Ankit02124/AquaSense/docs/images/components/CREDITS.md

# Image credits

Photos of off-the-shelf parts used in the README. All are under free licenses and were only resized.

| file | what | author | license | source |
|---|---|---|---|---|
| arduino_uno_q.png | Arduino UNO Q | Arduino | CC BY-SA 4.0 | [arduino/docs-content](https://github.com/arduino/docs-content/tree/main/content/hardware/uno/boards/uno-q/datasheet/assets) |
| uno_q_block_diagram.png | UNO Q block diagram (QRB2210 + STM32U585) | Arduino | CC BY-SA 4.0 | [arduino/docs-content](https://github.com/arduino/docs-content/tree/main/content/hardware/uno/boards/uno-q/datasheet/assets) |
| uno_q_pinout.png | UNO Q pinout | Arduino | CC BY-SA 4.0 | [arduino/docs-content](https://github.com/arduino/docs-content/tree/main/content/hardware/uno/boards/uno-q/datasheet/assets) |
| pond_aerator.jpg | Aerators in an aquaculture pond, Eluru (Andhra Pradesh) | iMahesh | CC BY-SA 4.0 | [Wikimedia Commons](https://commons.wikimedia.org/wiki/File:Aeration_system_in_a_Aqua_Pond,_Eluru.jpg) |
| ds18b20_probe.jpg | Waterproof DS18B20 probe | Leonardo Postay | CC BY-SA 4.0 | [Wikimedia Commons](https://commons.wikimedia.org/wiki/File:Sensor_DS18B20.jpg) |
| ph_electrode.jpg | Glass pH electrode | Chandrajit Karmakar | CC BY-SA 4.0 | [Wikimedia Commons](https://commons.wikimedia.org/wiki/File:Glass_electrode.jpg) |
| usb_webcam.jpg | USB webcam | WrS.tm.pl | CC0 | [Wikimedia Commons](https://commons.wikimedia.org/wiki/File:USB_webcam_for_PC.jpg) |
