Ankit02124/AquaSense/training/results/results.csv

epoch | time | train/box_loss | train/cls_loss | train/dfl_loss | metrics/precision(B) | metrics/recall(B) | metrics/mAP50(B) | metrics/mAP50-95(B) | val/box_loss | val/cls_loss | val/dfl_loss | lr/pg0 | lr/pg1 | lr/pg2
1 | 95.6696 | 1.91926 | 2.97007 | 1.28118 | 0.61665 | 0.44876 | 0.50786 | 0.28556 | 1.63518 | 1.78096 | 1.20926 | 0.00036933 | 0.00036933 | 0.00036933
2 | 161.121 | 1.71932 | 1.51549 | 1.17335 | 0.61072 | 0.54336 | 0.56353 | 0.30446 | 1.68945 | 1.80136 | 1.23338 | 0.000727459 | 0.000727459 | 0.000727459
3 | 228.603 | 1.66067 | 1.33646 | 1.14503 | 0.69011 | 0.63642 | 0.71373 | 0.41975 | 1.45755 | 1.23804 | 1.13942 | 0.00107337 | 0.00107337 | 0.00107337
4 | 296.022 | 1.58337 | 1.20881 | 1.10977 | 0.75004 | 0.66224 | 0.72667 | 0.42984 | 1.42364 | 1.12387 | 1.11456 | 0.00105601 | 0.00105601 | 0.00105601
5 | 362.528 | 1.52234 | 1.11287 | 1.089 | 0.82535 | 0.69847 | 0.79696 | 0.47769 | 1.3737 | 1.0721 | 1.09453 | 0.00103767 | 0.00103767 | 0.00103767
6 | 427.479 | 1.48979 | 1.05851 | 1.06753 | 0.83756 | 0.67762 | 0.81452 | 0.50773 | 1.30999 | 0.96612 | 1.07524 | 0.00101934 | 0.00101934 | 0.00101934
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
