Ankit02124/AquaSense/(commit log)

2026-11-05 Add STM32 sketch: probe power switching, ADC readings, DS2484 temperature
    Probes are powered one at a time, read with 64 samples and switched off
    again. Linux starts a measurement over the Bridge and polls for the raw
    millivolt result.
2026-11-05 Add wiring diagram, schematics and hardware notes
2026-11-05 Support three-point pH calibration (pH 4/7/10)
    Least-squares fit when more than two buffers are given. Also note in the
    hardware README that the DS18B20 steel sheath must be insulated, otherwise it
    grounds the circuit through the water and disturbs the pH reading.
2026-11-05 Scale overlays with frame size, add --start to run_on_video, use fish frames for samples
2026-11-06 Add trained YOLOv8n model and training notes
    Fine-tuned on the Brackish Dataset (Kaggle), 60 epochs at 640 px.
    Exported to ONNX at 416 px for the UNO Q. Includes training curves,
    confusion matrix, PR curve and sample predictions.
    [results.csv]
2026-11-06 Shorter track trails in overlays, tidy schematic titles
2026-11-06 Keep running when the MCU does not answer, and other app fixes
    - probes.py returns safe values on Bridge errors; the controller aborts,
    switches the probes off and retries after the follow-up interval
    - aerator switches off only once DO is a margin above the warning level
    - scheduled checks use the timezone from config.yaml
    - config.local.yaml is merged at any depth (settings.py)
    - windows too dark to see the fish raise no alerts
    - longest still time is the maximum over the whole window
    - main.py pings the MCU once a minute and saves at most one snapshot a minute
    - run_on_video.py can save clean frames for labelling (--save-raw)
    [config.yaml]
2026-11-06 Firmware: LED3 off until the first status, LED4 blue until Linux connects
    Also drop the abort flag, which could never reach Python.
2026-11-06 Restructure README and fix docs that did not match the code
    README now follows: problem statement, features, tech stack, system
    architecture, installation, usage, project structure, dataset and models,
    results, photos, future scope. Schematics get a white background so they
    are readable in GitHub dark mode.
2026-11-06 Add MQTT publishing (readings, alerts, status with Last Will), measure command, dashboard and broker tests
    [config.yaml]
